Ccmra404/stm32f103zet6-industrial-acquisition-controller/Firmware/stm32/Core/Src/main.c

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
/* Includes ------------------------------------------------------------------*/
#include "main.h"
#include "cmsis_os.h"
#include "adc.h"
#include "can.h"
#include "dac.h"
#include "dma.h"
#include "i2c.h"
#include "spi.h"
#include "usart.h"
#include "gpio.h"
#include "stm32f1xx_hal_iwdg.h"

/* USER CODE BEGIN Includes */
#if defined(UART4_VALIDATION) || defined(UART1_VALIDATION)
#include <string.h>
#endif
/* USER CODE END Includes */

IWDG_HandleTypeDef hiwdg;

void SystemClock_Config(void);
void MX_FREERTOS_Init(void);
#if !defined(UART4_VALIDATION) && !defined(UART1_VALIDATION)
static void MX_IWDG_Init(void);
#endif
/**
  * @brief  The application entry point.
  * @retval int
  */
#if defined(UART4_VALIDATION) || defined(UART1_VALIDATION)
static void ValidationWrite(const char *text)
{
  if (text != 0)
  {
#ifdef UART4_VALIDATION
    (void)HAL_UART_Transmit(&huart4,
                            (uint8_t *)text,
                            (uint16_t)strlen(text),
                            100U);
#else
    (void)HAL_UART_Transmit(&huart1,
                            (uint8_t *)text,
                            (uint16_t)strlen(text),
                            100U);
#endif
  }
}
#endif

int main(void)
{
#if defined(UART4_VALIDATION) || defined(UART1_VALIDATION)
  char line[64];
  uint16_t line_length = 0U;
  uint32_t last_alive_tick = 0U;

  HAL_Init();
  SystemClock_Config();
  MX_GPIO_Init();
#ifdef UART4_VALIDATION
  MX_UART4_Init();
  MX_USART1_UART_Init();
#else
  MX_USART1_UART_Init();
#endif

#ifdef UART4_VALIDATION
  ValidationWrite("\r\nSTM32 UART4 validation\r\n");
#else
  ValidationWrite("\r\nSTM32 USART1 validation\r\n");
#endif

  for (;;)
  {
    uint8_t byte;

#ifdef UART4_VALIDATION
    if (HAL_UART_Receive(&huart4, &byte, 1U, 10U) == HAL_OK)
#else
    if (HAL_UART_Receive(&huart1, &byte, 1U, 10U) == HAL_OK)
#endif
    {
      if ((byte == '\r') || (byte == '\n'))
      {
        if (line_length > 0U)
        {
          line[line_length] = '\0';
          if (strcmp(line, "PING") == 0)
          {
            ValidationWrite("PONG\r\n");
          }
          line_length = 0U;
        }
      }
      else if (line_length < (sizeof(line) - 1U))
      {
        line[line_length++] = (char)byte;
      }
    }

    if ((HAL_GetTick() - last_alive_tick) >= 1000U)
    {
      last_alive_tick = HAL_GetTick();
      ValidationWrite("STM32_ALIVE\r\n");
      HAL_GPIO_TogglePin(STATUS_LED_GPIO_Port, STATUS_LED_Pin);
    }
  }
#else
  /* MCU Configuration--------------------------------------------------------*/

  /* Reset of all peripherals, Initializes the Flash interface and the Systick. */
  HAL_Init();

  /* Configure the system clock */
  SystemClock_Config();

  /* Initialize all configured peripherals */
  MX_GPIO_Init();
  MX_DMA_Init();
  MX_ADC1_Init();
  MX_CAN_Init();
  MX_DAC_Init();
  MX_I2C1_Init();
  MX_I2C2_Init();
  MX_SPI2_Init();
  MX_SPI3_Init();
  MX_UART4_Init();
  MX_USART1_UART_Init();
  MX_USART2_UART_Init();
  MX_IWDG_Init();
  /* Init scheduler */
  osKernelInitialize();

  /* Call init function for freertos objects (in freertos.c) */
  MX_FREERTOS_Init();

  /* Start scheduler */
  osKernelStart();

  /* We should never get here as control is now taken by the scheduler */
  /* Infinite loop */
  /* USER CODE BEGIN WHILE */
  while (1)
  {

    /* USER CODE END WHILE */

    /* USER CODE BEGIN 3 */
  }
  /* USER CODE END 3 */
#endif
}

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
/* USER CODE BEGIN 4 */

#if !defined(UART4_VALIDATION) && !defined(UART1_VALIDATION)
static void MX_IWDG_Init(void)
{
  hiwdg.Instance = IWDG;
  hiwdg.Init.Prescaler = IWDG_PRESCALER_64;
  hiwdg.Init.Reload = 2500;
  if (HAL_IWDG_Init(&hiwdg) != HAL_OK)
  {
    Error_Handler();
  }
}
#endif

/* USER CODE END 4 */

/**
  * @brief  Period elapsed callback in non blocking mode
  * @note   This function is called  when TIM6 interrupt took place, inside
  * HAL_TIM_IRQHandler(). It makes a direct call to HAL_IncTick() to increment
  * a global variable "uwTick" used as application time base.
  * @param  htim : TIM handle
  * @retval None
  */
void HAL_TIM_PeriodElapsedCallback(TIM_HandleTypeDef *htim)
{
  if (htim->Instance == TIM6) {
    HAL_IncTick();
  }
}

/**
  * @brief  This function is executed in case of error occurrence.
  * @retval None
  */
void Error_Handler(void)
{
  /* USER CODE BEGIN Error_Handler_Debug */
  /* User can add his own implementation to report the HAL error return state */
  __disable_irq();
  while (1)
  {
  }
  /* USER CODE END Error_Handler_Debug */
}

#ifdef  USE_FULL_ASSERT
/**
  * @brief  Reports the name of the source file and the source line number
  *         where the assert_param error has occurred.
  * @param  file: pointer to the source file name
  * @param  line: assert_param error line source number
  * @retval None
  */
void assert_failed(uint8_t *file, uint32_t line)
{
  /* USER CODE BEGIN 6 */
  /* User can add his own implementation to report the file name and line number,
     ex: printf("Wrong parameters value: file %s on line %d\r\n", file, line) */
  /* USER CODE END 6 */
}
#endif /* USE_FULL_ASSERT */
