Ccmra404/stm32f103zet6-industrial-acquisition-controller/Firmware/stm32/Core/Src/app.c

#include "app.h"

#include "adc.h"
#include "ads1256.h"
#include "analog_output.h"
#include "bridge_protocol.h"
#include "cmsis_os.h"
#include "config_store.h"
#include "device_state.h"
#include "digital_input.h"
#include "field_comm.h"
#include "main.h"
#include "max31865.h"
#include "modbus_rtu.h"
#include "relay_output.h"
#include "usart.h"

#define LED_PERIOD_MS 500U
#define HEARTBEAT_PERIOD_MS 1000U
#define TELEMETRY_PERIOD_MS 100U
#define DIAGNOSTICS_PERIOD_MS 5000U
#define SUPPLY_PERIOD_MS 50U
#define CONTROL_PERIOD_MS 5U
#define ACQ_PERIOD_MS 100U
#define RTD_PERIOD_MS 500U
#define UART_RX_BUFFER_SIZE 256U
#define UART_RX_QUEUE_LENGTH 512U
#define EVENT_QUEUE_LENGTH 16U
#define COMMAND_CACHE_SIZE 16U

#define TASK_HEALTH_CONTROL 0U
#define TASK_HEALTH_ACQ 1U
#define TASK_HEALTH_MONITOR 2U
#define TASK_HEALTH_RTD 3U
#define TASK_HEALTH_BRIDGE 4U
#define TASK_HEALTH_MODBUS 5U

#define MODBUS_SLAVE_ADDRESS 1U
#define MODBUS_REGISTER_UPTIME 0x0000U
#define MODBUS_REGISTER_SUPPLY_24V 0x0001U
#define MODBUS_REGISTER_SUPPLY_5V 0x0002U
#define MODBUS_REGISTER_RTD 0x0003U
#define MODBUS_REGISTER_DI 0x0004U
#define MODBUS_REGISTER_RELAY 0x0005U
#define MODBUS_REGISTER_FAULT 0x0006U
#define MODBUS_REGISTER_AI_BASE 0x0010U
#define MODBUS_REGISTER_RELAY_CMD 0x0020U
#define MODBUS_REGISTER_DAC1_CMD 0x0021U
#define MODBUS_REGISTER_DAC2_CMD 0x0022U
#define MODBUS_REGISTER_CLEAR_FAULTS 0x0023U
#define MODBUS_WRITABLE_MASK ((UINT64_C(1) << MODBUS_REGISTER_RELAY_CMD) | \
                              (UINT64_C(1) << MODBUS_REGISTER_DAC1_CMD) |  \
                              (UINT64_C(1) << MODBUS_REGISTER_DAC2_CMD) |  \
                              (UINT64_C(1) << MODBUS_REGISTER_CLEAR_FAULTS))
#define MODBUS_FRAME_BUFFER_SIZE 256U

typedef struct
{
  uint32_t timestamp_ms;
  uint16_t event_code;
  uint32_t argument0;
  uint32_t argument1;
} AppEvent;

typedef struct
{
  uint16_t request_id;
  uint16_t command_id;
  int16_t result;
  uint16_t detail;
  uint8_t valid;
} CachedCommandResult;

static volatile uint16_t s_supply_raw[2];
static uint8_t s_uart_rx_buffer[UART_RX_BUFFER_SIZE];
static volatile uint32_t s_uart_rx_event_count;
static volatile uint32_t s_uart_rx_dropped;
static volatile uint32_t s_event_queue_dropped;
static osMessageQueueId_t s_uart_rx_queue;
static osMessageQueueId_t s_event_queue;
static osTimerId_t s_pulse_timers[8];
static osThreadId_t s_task_handles[DEVICE_TASK_COUNT];
static volatile uint32_t s_task_last_alive[DEVICE_TASK_COUNT];
static CachedCommandResult s_command_cache[COMMAND_CACHE_SIZE];
static uint8_t s_command_cache_index;
static uint32_t s_watchdog_refresh_count;
static uint16_t s_bridge_sequence;
static ModbusRtuServer s_modbus;

static const uint32_t s_task_deadline_ms[DEVICE_TASK_COUNT] = {
    100U,
    500U,
    500U,
    1600U,
    500U,
    300U,
};

static const osThreadAttr_t s_monitor_task_attributes = {
    .name = "monitorTask",
    .stack_size = 1024U,
    .priority = osPriorityAboveNormal,
};

static const osThreadAttr_t s_control_task_attributes = {
    .name = "controlTask",
    .stack_size = 1024U,
    .priority = osPriorityHigh,
};

static const osThreadAttr_t s_acq_task_attributes = {
    .name = "acqTask",
    .stack_size = 1536U,
    .priority = osPriorityHigh,
};

static const osThreadAttr_t s_rtd_task_attributes = {
    .name = "rtdTask",
    .stack_size = 1024U,
    .priority = osPriorityAboveNormal,
};

static const osThreadAttr_t s_bridge_task_attributes = {
    .name = "bridgeTask",
    .stack_size = 1536U,
    .priority = osPriorityNormal,
};

static const osThreadAttr_t s_modbus_task_attributes = {
    .name = "modbusTask",
    .stack_size = 1536U,
    .priority = osPriorityNormal,
};

static void MonitorTask(void *argument);
static void ControlTask(void *argument);
static void AcqTask(void *argument);
static void RtdTask(void *argument);
static void BridgeTask(void *argument);
static void ModbusTask(void *argument);
static void PulseTimerCallback(void *argument);
static void HandleCommandFrame(const BridgeProtocolFrame *frame);
static void SendAck(uint16_t request_id, uint16_t command_id, int16_t result, uint16_t detail);
static void TaskHealthReport(uint8_t task_index);
static void QueueEvent(const AppEvent *event);
static const CachedCommandResult *FindCachedCommand(uint16_t request_id, uint16_t command_id);
static void CacheCommandResult(uint16_t request_id,
                               uint16_t command_id,
                               int16_t result,
                               uint16_t detail);

static void TaskHealthReport(uint8_t task_index)
{
  if (task_index < DEVICE_TASK_COUNT)
  {
    s_task_last_alive[task_index] = osKernelGetTickCount() + 1U;
  }
}

static void QueueEvent(const AppEvent *event)
{
  if (event == 0)
  {
    return;
  }

  if (osMessageQueuePut(s_event_queue, event, 0U, 0U) != osOK)
  {
    s_event_queue_dropped++;
  }
}

static const CachedCommandResult *FindCachedCommand(uint16_t request_id, uint16_t command_id)
{
  for (uint8_t index = 0U; index < COMMAND_CACHE_SIZE; index++)
  {
    const CachedCommandResult *entry = &s_command_cache[index];

    if ((entry->valid != 0U) &&
        (entry->request_id == request_id) &&
        (entry->command_id == command_id))
    {
      return entry;
    }
  }

  return 0;
}

static void CacheCommandResult(uint16_t request_id,
                               uint16_t command_id,
                               int16_t result,
                               uint16_t detail)
{
  CachedCommandResult *entry = &s_command_cache[s_command_cache_index];

  entry->request_id = request_id;
  entry->command_id = command_id;
  entry->result = result;
  entry->detail = detail;
  entry->valid = 1U;
  s_command_cache_index = (uint8_t)((s_command_cache_index + 1U) % COMMAND_CACHE_SIZE);
}

static void ModbusUpdateRegisters(void)
{
  DeviceStateSnapshot state = DeviceState_Get();

  s_modbus.registers[MODBUS_REGISTER_UPTIME] = (uint16_t)(state.uptime_ms / 1000U);
  s_modbus.registers[MODBUS_REGISTER_SUPPLY_24V] = state.supply_24v_mv;
  s_modbus.registers[MODBUS_REGISTER_SUPPLY_5V] = state.supply_5v_mv;
  s_modbus.registers[MODBUS_REGISTER_RTD] = (uint16_t)(int16_t)(state.rtd_millicelsius / 100);
  s_modbus.registers[MODBUS_REGISTER_DI] = state.di_bits;
  s_modbus.registers[MODBUS_REGISTER_RELAY] = state.relay_bits;
  s_modbus.registers[MODBUS_REGISTER_FAULT] = state.fault_bits;

  for (uint8_t channel = 0U; channel < 8U; channel++)
  {
    uint32_t raw = (uint32_t)state.ai_raw[channel];
    s_modbus.registers[MODBUS_REGISTER_AI_BASE + (channel * 2U)] = (uint16_t)(raw & 0xFFFFU);
    s_modbus.registers[MODBUS_REGISTER_AI_BASE + (channel * 2U) + 1U] = (uint16_t)(raw >> 16U);
  }
}

static void ModbusApplyWrites(void)
{
  for (uint8_t index = 0U; index < s_modbus.write_count; index++)
  {
    uint16_t address = s_modbus.writes[index].address;
    uint16_t value = s_modbus.writes[index].value;

    switch (address)
    {
      case MODBUS_REGISTER_RELAY_CMD:
        if (value <= 0xFFU)
        {
          RelayOutput_SetMask((uint8_t)value);
        }
        break;

      case MODBUS_REGISTER_DAC1_CMD:
        if (value <= 4095U)
        {
          (void)AnalogOutput_SetRaw(0U, value);
        }
        break;

      case MODBUS_REGISTER_DAC2_CMD:
        if (value <= 4095U)
        {
          (void)AnalogOutput_SetRaw(1U, value);
        }
        break;

      case MODBUS_REGISTER_CLEAR_FAULTS:
        DeviceState_ClearFaults(value);
        break;

      default:
        break;
    }
  }
}

void App_Init(void)
{
  DeviceState_Init();
  ConfigStore_Init();
  RelayOutput_Init();
  AnalogOutput_Init();
  DigitalInput_Init();
  MAX31865_Init();

  if (ADS1256_Init() == 0U)
  {
    DeviceState_SetFault(DEVICE_FAULT_ADS1256, 1U);
  }

  if (FieldComm_Init() == 0U)
  {
    DeviceState_SetFault(DEVICE_FAULT_COMM, 1U);
  }

  ModbusRtu_Init(&s_modbus, MODBUS_SLAVE_ADDRESS, MODBUS_WRITABLE_MASK);

  s_uart_rx_queue = osMessageQueueNew(UART_RX_QUEUE_LENGTH, sizeof(uint8_t), NULL);
  s_event_queue = osMessageQueueNew(EVENT_QUEUE_LENGTH, sizeof(AppEvent), NULL);
  if ((s_uart_rx_queue == NULL) || (s_event_queue == NULL))
  {
    Error_Handler();
  }

  for (uint8_t channel = 0U; channel < 8U; channel++)
  {
    s_pulse_timers[channel] = osTimerNew(PulseTimerCallback,
                                         osTimerOnce,
                                         (void *)(uintptr_t)channel,
                                         NULL);
    if (s_pulse_timers[channel] == NULL)
    {
      Error_Handler();
    }
  }

  if (HAL_ADC_Start_DMA(&hadc1, (uint32_t *)s_supply_raw, 2U) != HAL_OK)
  {
    Error_Handler();
  }

  if (HAL_UARTEx_ReceiveToIdle_DMA(&huart1, s_uart_rx_buffer, UART_RX_BUFFER_SIZE) != HAL_OK)
  {
    Error_Handler();
  }
}

void App_CreateTasks(void)
{
  s_task_handles[TASK_HEALTH_MONITOR] =
      osThreadNew(MonitorTask, NULL, &s_monitor_task_attributes);
  if (s_task_handles[TASK_HEALTH_MONITOR] == NULL)
  {
    Error_Handler();
  }

  s_task_handles[TASK_HEALTH_CONTROL] =
      osThreadNew(ControlTask, NULL, &s_control_task_attributes);
  if (s_task_handles[TASK_HEALTH_CONTROL] == NULL)
  {
    Error_Handler();
  }

  s_task_handles[TASK_HEALTH_ACQ] =
      osThreadNew(AcqTask, NULL, &s_acq_task_attributes);
  if (s_task_handles[TASK_HEALTH_ACQ] == NULL)
  {
    Error_Handler();
  }

  s_task_handles[TASK_HEALTH_RTD] =
      osThreadNew(RtdTask, NULL, &s_rtd_task_attributes);
  if (s_task_handles[TASK_HEALTH_RTD] == NULL)
  {
    Error_Handler();
  }

  s_task_handles[TASK_HEALTH_BRIDGE] =
      osThreadNew(BridgeTask, NULL, &s_bridge_task_attributes);
  if (s_task_handles[TASK_HEALTH_BRIDGE] == NULL)
  {
    Error_Handler();
  }

  s_task_handles[TASK_HEALTH_MODBUS] =
      osThreadNew(ModbusTask, NULL, &s_modbus_task_attributes);
  if (s_task_handles[TASK_HEALTH_MODBUS] == NULL)
  {
    Error_Handler();
  }
}

static void MonitorTask(void *argument)
{
  uint32_t last_led_tick = osKernelGetTickCount();

  (void)argument;

  for (;;)
  {
    uint32_t now = osKernelGetTickCount();
    uint16_t mv_24v = (uint16_t)(((uint32_t)s_supply_raw[0] * 36300U) / 4095U);
    uint16_t mv_5v = (uint16_t)(((uint32_t)s_supply_raw[1] * 6600U) / 4095U);
    uint32_t alive_mask = 0U;
    uint16_t stack_free[DEVICE_TASK_COUNT] = {0U};

    TaskHealthReport(TASK_HEALTH_MONITOR);

    for (uint8_t index = 0U; index < DEVICE_TASK_COUNT; index++)
    {
      uint32_t last_alive = s_task_last_alive[index];

      if ((s_task_handles[index] != NULL) &&
          (last_alive != 0U) &&
          ((now - (last_alive - 1U)) <= s_task_deadline_ms[index]))
      {
        alive_mask |= (1UL << index);
      }

      if (s_task_handles[index] != NULL)
      {
        uint32_t free_bytes = osThreadGetStackSpace(s_task_handles[index]);
        stack_free[index] = (free_bytes > 0xFFFFU) ? 0xFFFFU : (uint16_t)free_bytes;
      }
    }

    if (alive_mask == ((1UL << DEVICE_TASK_COUNT) - 1UL))
    {
      (void)HAL_IWDG_Refresh(&hiwdg);
      s_watchdog_refresh_count++;
      DeviceState_SetFault(DEVICE_FAULT_RUNTIME, 0U);
    }
    else
    {
      DeviceState_SetFault(DEVICE_FAULT_RUNTIME, 1U);
    }

    DeviceState_UpdateSupplies(s_supply_raw[0], s_supply_raw[1], mv_24v, mv_5v);
    DeviceState_UpdateRuntimeDiagnostics(alive_mask,
                                         stack_free,
                                         s_uart_rx_dropped,
                                         s_event_queue_dropped,
                                         s_watchdog_refresh_count);

    if ((now - last_led_tick) >= LED_PERIOD_MS)
    {
      last_led_tick = now;
      HAL_GPIO_TogglePin(STATUS_LED_GPIO_Port, STATUS_LED_Pin);
    }

    osDelay(SUPPLY_PERIOD_MS);
  }
}

static void ControlTask(void *argument)
{
  uint8_t previous_di = 0U;

  (void)argument;

  for (;;)
  {
    uint8_t current_di;

    TaskHealthReport(TASK_HEALTH_CONTROL);
    DigitalInput_Update();
    current_di = DigitalInput_GetStableBits();
    DeviceState_UpdateDigital(current_di, RelayOutput_GetMask());

    if (current_di != previous_di)
    {
      AppEvent event = {
          .timestamp_ms = osKernelGetTickCount(),
          .event_code = BRIDGE_EVENT_DIGITAL_INPUT,
          .argument0 = current_di,
          .argument1 = (uint32_t)(current_di ^ previous_di),
      };
      QueueEvent(&event);
      previous_di = current_di;
    }

    osDelay(CONTROL_PERIOD_MS);
  }
}

static void AcqTask(void *argument)
{
  int32_t values[8];

  (void)argument;

  for (;;)
  {
    TaskHealthReport(TASK_HEALTH_ACQ);
    if (ADS1256_ReadAll(values) != 0U)
    {
      DeviceState_UpdateAnalogInputs(values);
    }
    else
    {
      DeviceState_SetFault(DEVICE_FAULT_ADS1256, 1U);
    }

    osDelay(ACQ_PERIOD_MS);
  }
}

static void RtdTask(void *argument)
{
  (void)argument;

  for (;;)
  {
    int32_t temperature_millicelsius = 0;
    uint8_t valid = MAX31865_ReadMilliCelsius(&temperature_millicelsius);

    TaskHealthReport(TASK_HEALTH_RTD);
    DeviceState_UpdateTemperature(temperature_millicelsius, (valid == 0U) ? 1U : 0U);
    osDelay(RTD_PERIOD_MS);
  }
}

static void BridgeTask(void *argument)
{
  BridgeProtocolParser parser;
  BridgeProtocolFrame frame;
  uint32_t last_heartbeat_tick = osKernelGetTickCount();
  uint32_t last_telemetry_tick = osKernelGetTickCount();
  uint32_t last_diagnostics_tick = osKernelGetTickCount();

  (void)argument;

  BridgeProtocol_ParserInit(&parser);

  {
    uint8_t hello[32];
    uint16_t hello_length = BridgeProtocol_BuildHello(s_bridge_sequence++,
                                                      BRIDGE_ROLE_STM32,
                                                      0x0100U,
                                                      BRIDGE_CAP_ANALOG_INPUT |
                                                      BRIDGE_CAP_TEMPERATURE |
                                                      BRIDGE_CAP_DIGITAL_INPUT |
                                                      BRIDGE_CAP_RELAY_OUTPUT |
                                                      BRIDGE_CAP_ANALOG_OUTPUT |
                                                      BRIDGE_CAP_RS485 |
                                                      BRIDGE_CAP_RS232 |
                                                      BRIDGE_CAP_CAN |
                                                      BRIDGE_CAP_EEPROM,
                                                      hello,
                                                      sizeof(hello));
    if (hello_length > 0U)
    {
      (void)HAL_UART_Transmit(&huart1, hello, hello_length, 20U);
    }
  }

  for (;;)
  {
    uint8_t byte;
    uint32_t now = osKernelGetTickCount();
    DeviceStateSnapshot state = DeviceState_Get();
    uint8_t output[BRIDGE_PROTOCOL_MAX_FRAME_SIZE];
    uint16_t length;

    TaskHealthReport(TASK_HEALTH_BRIDGE);
    DeviceState_UpdateUart(s_uart_rx_event_count);

    while (osMessageQueueGet(s_uart_rx_queue, &byte, NULL, 0U) == osOK)
    {
      if (BridgeProtocol_ParserPushByte(&parser, byte, &frame))
      {
        if (frame.type == BRIDGE_MSG_COMMAND)
        {
          HandleCommandFrame(&frame);
        }
      }
    }

    {
      AppEvent event;
      while (osMessageQueueGet(s_event_queue, &event, NULL, 0U) == osOK)
      {
        length = BridgeProtocol_BuildEvent(s_bridge_sequence++,
                                           event.timestamp_ms,
                                           event.event_code,
                                           event.argument0,
                                           event.argument1,
                                           output,
                                           sizeof(output));
        if (length > 0U)
        {
          (void)HAL_UART_Transmit(&huart1, output, length, 20U);
        }
      }
    }

    {
      uint8_t bus_data[BRIDGE_BUS_RX_MAX_DATA];
      uint16_t bus_length = FieldComm_ReadRs232Bytes(bus_data, sizeof(bus_data));

      if (bus_length > 0U)
      {
        length = BridgeProtocol_BuildBusRx(s_bridge_sequence++,
                                           BRIDGE_BUS_RS232,
                                           0U,
                                           bus_data,
                                           (uint8_t)bus_length,
                                           output,
                                           sizeof(output));
        if (length > 0U)
        {
          (void)HAL_UART_Transmit(&huart1, output, length, 20U);
        }
      }
    }

    {
      FieldCommCanFrame can_frame;

      while (FieldComm_ReadCanFrame(&can_frame, 0U) != 0U)
      {
        length = BridgeProtocol_BuildBusRx(s_bridge_sequence++,
                                           BRIDGE_BUS_CAN,
                                           can_frame.identifier,
                                           can_frame.data,
                                           can_frame.length,
                                           output,
                                           sizeof(output));
        if (length > 0U)
        {
          (void)HAL_UART_Transmit(&huart1, output, length, 20U);
        }
      }
    }

    if ((now - last_heartbeat_tick) >= HEARTBEAT_PERIOD_MS)
    {
      length = BridgeProtocol_BuildHeartbeat(s_bridge_sequence++,
                                             state.uptime_ms,
                                             1U,
                                             state.fault_bits,
                                             output,
                                             sizeof(output));
      last_heartbeat_tick = now;
      if (length > 0U)
      {
        (void)HAL_UART_Transmit(&huart1, output, length, 20U);
      }
    }

    if ((now - last_telemetry_tick) >= TELEMETRY_PERIOD_MS)
    {
      uint16_t supply_mv[2] = {state.supply_24v_mv, state.supply_5v_mv};

      length = BridgeProtocol_BuildTelemetry(s_bridge_sequence++,
                                             state.uptime_ms,
                                             state.ai_raw,
                                             state.rtd_millicelsius,
                                             state.di_bits,
                                             state.relay_bits,
                                             supply_mv,
                                             state.fault_bits,
                                             state.analog_output_raw,
                                             output,
                                             sizeof(output));
      last_telemetry_tick = now;
      if (length > 0U)
      {
        (void)HAL_UART_Transmit(&huart1, output, length, 20U);
      }
    }

    if ((now - last_diagnostics_tick) >= DIAGNOSTICS_PERIOD_MS)
    {
      length = BridgeProtocol_BuildDiagnostics(s_bridge_sequence++,
                                               state.uptime_ms,
                                               state.task_alive_bits,
                                               state.uart_rx_dropped,
                                               state.event_queue_dropped,
                                               state.watchdog_refresh_count,
                                               state.task_stack_free,
                                               output,
                                               sizeof(output));
      last_diagnostics_tick = now;
      if (length > 0U)
      {
        (void)HAL_UART_Transmit(&huart1, output, length, 20U);
      }
    }

    osDelay(10U);
  }
}

static void ModbusTask(void *argument)
{
  uint8_t request[MODBUS_FRAME_BUFFER_SIZE];
  uint8_t response[MODBUS_FRAME_BUFFER_SIZE];
  uint16_t request_length = 0U;
  uint32_t last_rx_tick = 0U;

  (void)argument;

  for (;;)
  {
    uint8_t byte;
    uint32_t now;

    TaskHealthReport(TASK_HEALTH_MODBUS);

    if (FieldComm_ReadRs485Byte(&byte, 2U) != 0U)
    {
      if (request_length < sizeof(request))
      {
        request[request_length++] = byte;
      }
      else
      {
        request_length = 0U;
      }
      last_rx_tick = osKernelGetTickCount();
      continue;
    }

    now = osKernelGetTickCount();
    if ((request_length > 0U) && ((now - last_rx_tick) >= 2U))
    {
      uint16_t response_length;

      ModbusUpdateRegisters();
      response_length = ModbusRtu_Process(&s_modbus,
                                          request,
                                          request_length,
                                          response,
                                          sizeof(response));
      if (response_length > 0U)
      {
        (void)FieldComm_SendRs485(response, response_length, 50U);
      }
      ModbusApplyWrites();
      request_length = 0U;
    }
  }
}

static void HandleCommandFrame(const BridgeProtocolFrame *frame)
{
  BridgeProtocolCommand command;
  const CachedCommandResult *cached;
  int16_t result = BRIDGE_RESULT_UNSUPPORTED;
  uint16_t detail = 0U;

  if (BridgeProtocol_ParseCommand(frame, &command) == false)
  {
    SendAck(0U, 0U, BRIDGE_RESULT_INVALID_ARGUMENT, 0U);
    return;
  }

  cached = FindCachedCommand(command.request_id, command.command_id);
  if (cached != 0)
  {
    SendAck(command.request_id, command.command_id, cached->result, cached->detail);
    return;
  }

  switch (command.command_id)
  {
    case BRIDGE_CMD_SET_RELAY_MASK:
      if ((command.argument1 & 0xFFFFFF00U) == 0U)
      {
        RelayOutput_SetMask((uint8_t)command.argument0);
        {
          AppEvent event = {
              .timestamp_ms = osKernelGetTickCount(),
              .event_code = BRIDGE_EVENT_RELAY_CHANGE,
              .argument0 = RelayOutput_GetMask(),
              .argument1 = command.request_id,
          };
          QueueEvent(&event);
        }
        result = BRIDGE_RESULT_OK;
      }
      else
      {
        result = BRIDGE_RESULT_INVALID_ARGUMENT;
      }
      break;

    case BRIDGE_CMD_SET_ANALOG_OUTPUT:
      if ((command.argument0 <= 1U) && (command.argument1 <= 4095U))
      {
        result = (AnalogOutput_SetRaw((uint8_t)command.argument0,
                                      (uint16_t)command.argument1) != 0U)
                     ? BRIDGE_RESULT_OK
                     : BRIDGE_RESULT_NOT_READY;
      }
      else
      {
        result = BRIDGE_RESULT_OUT_OF_RANGE;
      }
      break;

    case BRIDGE_CMD_PULSE_RELAY:
      if ((command.argument0 < 8U) &&
          (command.argument1 > 0U) &&
          (command.argument1 <= 60000U))
      {
        uint8_t mask = RelayOutput_GetMask();
        mask |= (uint8_t)(1U << command.argument0);
        RelayOutput_SetMask(mask);
        {
          AppEvent event = {
              .timestamp_ms = osKernelGetTickCount(),
              .event_code = BRIDGE_EVENT_RELAY_CHANGE,
              .argument0 = mask,
              .argument1 = command.request_id,
          };
          QueueEvent(&event);
        }
        result = (osTimerStart(s_pulse_timers[command.argument0],
                               command.argument1) == osOK)
                     ? BRIDGE_RESULT_OK
                     : BRIDGE_RESULT_BUSY;
      }
      else
      {
        result = BRIDGE_RESULT_INVALID_ARGUMENT;
      }
      break;

    case BRIDGE_CMD_CLEAR_FAULTS:
      DeviceState_ClearFaults((uint16_t)command.argument0);
      result = BRIDGE_RESULT_OK;
      break;

    case BRIDGE_CMD_SAVE_CONFIG:
      if (ConfigStore_Save() != 0U)
      {
        DeviceState_ClearFaults(DEVICE_FAULT_CONFIG);
        result = BRIDGE_RESULT_OK;
      }
      else
      {
        DeviceState_SetFault(DEVICE_FAULT_CONFIG, 1U);
        result = BRIDGE_RESULT_STORAGE_ERROR;
      }
      break;

    case BRIDGE_CMD_LOAD_CONFIG:
      if (ConfigStore_Load() != 0U)
      {
        DeviceState_ClearFaults(DEVICE_FAULT_CONFIG);
        result = BRIDGE_RESULT_OK;
      }
      else
      {
        DeviceState_SetFault(DEVICE_FAULT_CONFIG, 1U);
        result = BRIDGE_RESULT_STORAGE_ERROR;
      }
      break;

    default:
      result = BRIDGE_RESULT_UNSUPPORTED;
      break;
  }

  CacheCommandResult(command.request_id, command.command_id, result, detail);
  SendAck(command.request_id, command.command_id, result, detail);
}

static void PulseTimerCallback(void *argument)
{
  uint8_t channel = (uint8_t)(uintptr_t)argument;
  uint8_t mask = RelayOutput_GetMask() & (uint8_t)~(1U << channel);
  RelayOutput_SetMask(mask);
}

static void SendAck(uint16_t request_id, uint16_t command_id, int16_t result, uint16_t detail)
{
  uint8_t output[32];
  uint16_t length = BridgeProtocol_BuildCommandAck(s_bridge_sequence++,
                                                   request_id,
                                                   command_id,
                                                   result,
                                                   detail,
                                                   output,
                                                   sizeof(output));

  if (length > 0U)
  {
    (void)HAL_UART_Transmit(&huart1, output, length, 20U);
  }
}

void HAL_UARTEx_RxEventCallback(UART_HandleTypeDef *huart, uint16_t size)
{
  if (huart->Instance == USART1)
  {
    uint16_t index;

    for (index = 0U; index < size; index++)
    {
      if (osMessageQueuePut(s_uart_rx_queue, &s_uart_rx_buffer[index], 0U, 0U) != osOK)
      {
        s_uart_rx_dropped++;
      }
    }

    s_uart_rx_event_count++;
    (void)HAL_UARTEx_ReceiveToIdle_DMA(&huart1, s_uart_rx_buffer, UART_RX_BUFFER_SIZE);
  }
}

void HAL_UART_ErrorCallback(UART_HandleTypeDef *huart)
{
  if (huart->Instance == USART1)
  {
    (void)HAL_UARTEx_ReceiveToIdle_DMA(&huart1, s_uart_rx_buffer, UART_RX_BUFFER_SIZE);
  }

  FieldComm_OnUartError(huart);
}

void HAL_ADC_ErrorCallback(ADC_HandleTypeDef *hadc)
{
  if (hadc->Instance == ADC1)
  {
    Error_Handler();
  }
}
