Ccmra404/stm32f103zet6-industrial-acquisition-controller/(commit log)

2026-09-19 Add rendered architecture and data flow diagrams
2026-09-19 Add PCB layout preview
2026-09-19 Define firmware architecture and inter-board protocol
2026-09-19 Add STM32CubeMX configuration checklist
2026-09-19 Align documentation with final UART pin direction
2026-09-19 Add complete STM32 and ESP32 firmware
2026-09-20 Add Home Assistant control console and ESP32 services
    Add the ESP32 HTTPS console, link health monitoring, network security, and Home Assistant MQTT Discovery.
    Add the Tabler control console, Mosquitto deployment files, and Mushroom dashboard configuration.
    Add dual-board UART validation projects and update the network and firmware documentation.
    [industrial_controller_dashboard.yaml]
2026-09-20 Add per-channel relay controls
    Make each relay bitmap position a control button and update the relay mask through the Home Assistant number entity.
    Document per-channel relay switching in the Home Assistant console guide.
2026-09-20 Generate development certificate in CI
    Create the local self-signed certificate before the ESP32 build so a clean checkout can compile without committing private key material.
2026-09-20 Add field-bus receive path and closed-loop command feedback
    - STM32: interrupt-driven RS232 (UART4) and CAN FIFO0 receive with software queues; NVIC for UART4 and CAN1_RX0 enabled in the CubeMX config and MSP init
    - Protocol: new 0x13 BUS_RX message forwards frames to the ESP32-S3, which publishes them on industrial/bus and exposes a Home Assistant sensor
    - Modbus: master request builders and response parser with round-trip tests alongside the existing slave implementation
    - Console: wait for a new ACK sequence before reporting success, then read the relay mask back and show timeout or error codes from the device
    - Relay: report the real GPIO latch state instead of a cached software mask
    [industrial_controller_dashboard.yaml]
2026-09-20 Rate-limit field-bus MQTT publishing and make ACK sequence atomic
    A fast RS232 or CAN source could otherwise publish hundreds of MQTT messages per second; frames are still counted and cached, only the publish rate is capped at 100 ms. The ACK sequence now uses an atomic increment because both the MQTT callback and the command task can publish results.
2026-09-20 Polish the control console offline and data presentation
    - unavailable entities now render as -- with a gateway-offline banner instead of dumping raw state strings
    - telemetry table formats temperature, voltage and bitmaps, and shows each entity's own last_updated with a stale marker
    - empty charts show a placeholder instead of a flat axis, and samples are only appended when data is numeric
    - access tokens refresh with the stored refresh token before falling back to the login screen
    - polling pauses on hidden tabs, command buttons are locked while a command is in flight, and relay bits are disabled when data is unavailable
2026-09-20 Complete the web console: per-channel pulse, DAC output, bus and fault panels
    - telemetry now carries DAC1/DAC2 read-back so the console can confirm analog output instead of trusting the setpoint
    - ESP32 publishes eight per-channel pulse buttons and two DAC number entities; pulse payloads omit the id so every press gets a fresh request id and is not answered from the STM32 duplicate cache
    - console adds channel/duration pulse control, DAC sliders with read-back badges, a field-bus frame panel, a fault-bit breakdown and a persisted 20-entry command log
    - pulse and DAC commands go out through the Home Assistant mqtt.publish service and still wait for a matching ACK sequence
    - docs updated; STM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
2026-09-20 Remove the duplicated single-channel pulse shortcut
    The command bar still carried the old channel-1 pulse button next to the new pulse row that selects any channel and duration, so it was removed together with its entity mapping and handler branch.
2026-09-20 Link the v1.0.0 release from the project overview
    The prebuilt STM32 hex and ESP32-S3 bin are attached to the release, so the README now points at them and repeats the requirement to flash both together.
2026-09-20 Replace the overview screenshot with two current console captures
    The old dashboard image still showed the four-entry sidebar without the field-bus and command-log sections. Two fresh captures (overview/trend and digital/field-bus/control) now sit side by side at 49% width, stored as WebP to keep the repository small.
