Ccmra404/stm32f103zet6-industrial-acquisition-controller/(notices)

Notices in the files:
Firmware/stm32/Core/Src/main.c:
Copyright (c) 2026 STMicroelectronics.
All rights reserved.
This software is licensed under terms that can be found in the LICENSE file
